cybaer/derTempomat/Hardware/dd.kicad_pcb

## KiCad design Hardware/dd.kicad_pcb (2018-09-26)

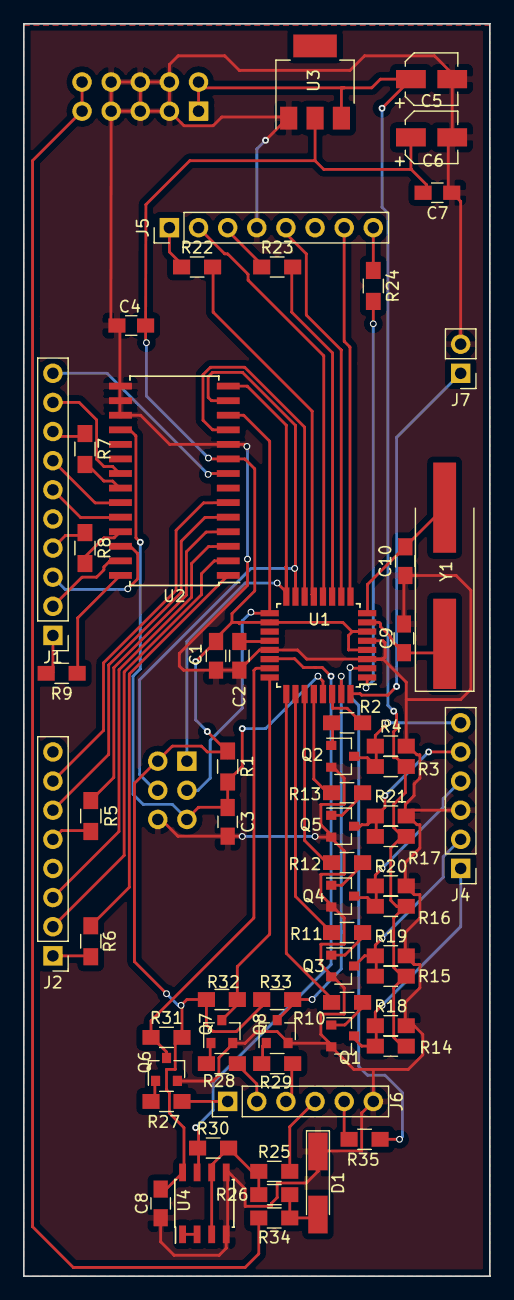
[picture p1: board dd.kicad_pcb from above]

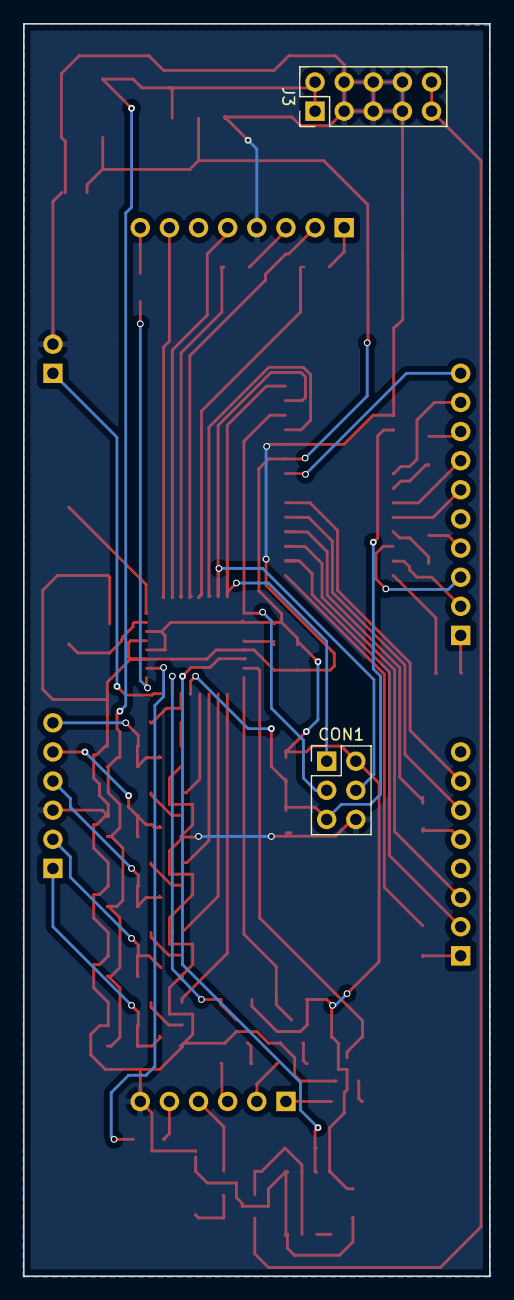
[picture p2: board dd.kicad_pcb from below]

Board: 2 copper layers, 40.6 x 109.2 mm, 67 parts (2 on the bottom side), 73 nets.

Parts:
C1, C2, C3, C4, C7, C8: 100n; C_0805_HandSoldering
C5, C6: 22µ; CP_Elec_4x5.3
C9, C10: 20p; C_0805_HandSoldering
CON1: AVR-ISP-6; Pin_Header_Straight_2x03_Pitch2.54mm
D1: 5V1; D_MiniMELF_Handsoldering
J1: Pin_Header_Straight_1x10_Pitch2.54mm
J2: Pin_Header_Straight_1x08_Pitch2.54mm
J3: Conn_02x05_Odd_Even; Pin_Header_Straight_2x05_Pitch2.54mm
J4, J6: Pin_Header_Straight_1x06_Pitch2.54mm
J5: Conn_01x08_Male; Pin_Header_Straight_1x08_Pitch2.54mm
J7: Conn_01x02_Male; Pin_Header_Straight_1x02_Pitch2.54mm
Q1, Q2, Q3, Q4, Q5, Q6, Q7, Q8: MMBT3904; SOT-23
R1, R2, R10, R11, R12, R13, R31, R32, R33: 10K; R_0805_HandSoldering
R3, R14, R15, R16, R17: 4K7; R_0805_HandSoldering
R4, R18, R19, R20, R21: 3K3; R_0805_HandSoldering
R5, R6, R7, R8, R9, R22, R23, R24, R35: 1K; R_0805_HandSoldering
R25, R26, R27, R28, R29, R30: 100K; R_0805_HandSoldering
R34: 5K; R_0805_HandSoldering
U1: ATMEGA328P-AU; TQFP-32_7x7mm_Pitch0.8mm
U2: MCP23S17; SOIC-28W_7.5x17.9mm_Pitch1.27mm
U3: LM1117-5.0; SOT-223
U4: MCP6002-xSN; SOIC-8_3.9x4.9mm_Pitch1.27mm
Y1: 20MHz; Crystal_SMD_HC49-SD_HandSoldering

Connections:
+12V: C5.1, J3.1, J3.2, R3.2, R14.2, R15.2, R16.2, R17.2, U3.3
-12VA: J3.9, J3.10, R34.2
-Ref: D1.2, R26.2, R34.1
/CV: R30.1, U1.22, U4.7
/Clk: Q6.3, R31.1, U1.23
/Debug: J7.1, U1.32
/LED1: R22.2, U1.13
/LED2: R23.2, U1.11
/LED3: R24.2, U1.1
/LED4: R35.2, U1.2
/Mod: Q8.3, R33.1, U1.31
/Rst: Q7.3, R32.1, U1.24
/T1: J5.2, U1.12
/T2: J5.5, U1.10
/T3: J5.7, U1.9
GND: C1.2, C2.2, C3.2, C4.2, C5.2, C6.2, C7.2, C8.2, C9.1, C10.1, CON1.6, D1.1, J3.3, J3.4, J3.5, J3.6, J3.7, J3.8, J4.3, J5.4, J6.6, J7.2, Q1.2, Q2.2, Q3.2, Q4.2, Q5.2, Q6.2, Q7.2, Q8.2, R4.2, R18.2, R19.2, R20.2, R21.2, U1.3, U1.5, U1.21, U2.10, U2.15, U2.16, U2.17, U3.1, U4.4, U4.5
unnamed: C2.1, U1.20
unnamed: C3.1, CON1.5, R1.2, U1.29, U2.18
unnamed: C9.2, U1.7, Y1.1
unnamed: C10.2, U1.8, Y1.2
unnamed: CON1.1, U1.16, U2.14
unnamed: CON1.3, U1.17, U2.12
unnamed: CON1.4, U1.15, U2.13
unnamed: J1.1, R9.1
unnamed: J1.2, U2.27
unnamed: J1.3, U2.26
unnamed: J1.4, R8.1
unnamed: J1.6, U2.24
unnamed: J1.7, U2.23
unnamed: J1.8, R7.1
unnamed: J1.9, U2.21
unnamed: J1.10, U2.8
unnamed: J2.1, R6.1
unnamed: J2.2, U2.2
unnamed: J2.3, U2.3
unnamed: J2.5, R5.1
unnamed: J2.6, U2.5
unnamed: J2.7, U2.6
unnamed: J4.1, Q1.3, R14.1, R18.1
unnamed: J4.2, Q3.3, R15.1, R19.1
unnamed: J4.4, Q4.3, R16.1, R20.1
unnamed: J4.5, Q5.3, R17.1, R21.1
unnamed: J4.6, Q2.3, R3.1, R4.1
unnamed: J5.1, R22.1
unnamed: J5.3, R23.1
unnamed: J5.8, R24.1
unnamed: J6.1, R27.2
unnamed: J6.2, R28.2
unnamed: J6.3, R29.2
unnamed: J6.4, R25.2
unnamed: J6.5, R35.1
unnamed: Q1.1, R10.1
unnamed: Q2.1, R2.1
unnamed: Q3.1, R11.1
unnamed: Q4.1, R12.1
unnamed: Q5.1, R13.1
unnamed: Q6.1, R27.1
unnamed: Q7.1, R28.1
unnamed: Q8.1, R29.1
unnamed: R2.2, U1.30
unnamed: R5.2, U2.4
unnamed: R6.2, U2.1
unnamed: R7.2, U2.22
unnamed: R8.2, U2.25
unnamed: R9.2, U2.28
unnamed: R10.2, U1.25
unnamed: R11.2, U1.26
unnamed: R12.2, U1.27
unnamed: R13.2, U1.28
unnamed: R25.1, R26.1, R30.2, U4.3, U4.6
unnamed: U1.14, U2.11
unnamed: U4.1, U4.2
VCC: C1.1, C4.1, C6.1, C7.1, C8.1, CON1.2, R1.1, R31.2, R32.2, R33.2, U1.4, U1.6, U1.18, U2.9, U3.2, U4.8
