cybaer/derTempomat/HardwareConfig.h

/*
 * HardwareConfig.h
 *
 *  Created on: 19.07.2018
 *      Author: cybaer
 *
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
 */

#ifndef HARDWARECONFIG_H_
#define HARDWARECONFIG_H_

#include "lib/ui/EdgeTrigger.h"
#include "avrlib/devices/switch.h"
#include "avrlib/devices/mcp23s17.h"
#include "avrlib/devices/bicolor_led_group.h"
#include "avrlib/devices/switch_group.h"


#include "avrlib/base.h"
#include "avrlib/gpio.h"
#include "avrlib/spi.h"
#include "avrlib/adc.h"

// __Compiler Bug__
__extension__ typedef int __guard __attribute__((mode (__DI__)));

extern "C" int __cxa_guard_acquire(__guard *);
extern "C" void __cxa_guard_release (__guard *);
extern "C" void __cxa_guard_abort (__guard *);
extern "C" void __cxa_pure_virtual();


using namespace avrlib;
static const uint8_t MAX_CV = 122;

typedef DebouncedSwitch< Gpio<PortB, 0> > Button_A;  // 12
typedef DebouncedSwitch< Gpio<PortD, 6> > Button_B;  // 10
typedef DebouncedSwitch< Gpio<PortD, 5> > Button_Mod;  // 9

typedef Gpio<PortB, 1> LED_A;  // 13
typedef Gpio<PortD, 7> LED_B;  // 11
typedef Gpio<PortD, 3> LED_Mod;  // 1
typedef Gpio<PortD, 4> LED_Takt;  // 2

typedef EdgeTrigger<Gpio<PortC, 0>, 0> ClockIn;  // 23
typedef EdgeTrigger<Gpio<PortC, 1>, 0> ResetIn;  // 24
typedef Gpio<PortD, 1> ModIn;  // 31

typedef Inverter<Gpio<PortC, 2> > Output_5;  // 6
typedef Inverter<Gpio<PortC, 3> > Output_4;  // 4
typedef Inverter<Gpio<PortC, 5> > Output_3;  // 2
typedef Inverter<Gpio<PortC, 4> > Output_2;  // 3
typedef Inverter<Gpio<PortD, 0> > Output_1;  // 1

// HW SPI
static const uint8_t SPI_Speed = 4;
typedef SpiMasterBase<MSB_FIRST, SPI_Speed> spi_master;

// Port Extender
typedef Gpio<PortB, 2> ExtenderSlaveSelect;
typedef MCP23S17<spi_master, ExtenderSlaveSelect, 0> portExtender;

typedef LED<PortPin<portExtender, PORT_A, 0>, PortPin<portExtender, PORT_A, 1> > LED_1;
typedef LED<PortPin<portExtender, PORT_A, 3>, PortPin<portExtender, PORT_A, 4> > LED_2;
typedef LED<PortPin<portExtender, PORT_A, 5>, PortPin<portExtender, PORT_A, 7> > LED_3;
typedef LED<PortPin<portExtender, PORT_B, 5>, PortPin<portExtender, PORT_B, 3> > LED_4;
typedef LED<PortPin<portExtender, PORT_B, 2>, PortPin<portExtender, PORT_B, 0> > LED_5;

typedef Switch<portExtender, PORT_B, 7> Switch_1;
typedef Switch<portExtender, PORT_A, 2> Switch_2;
typedef Switch<portExtender, PORT_A, 6> Switch_3;
typedef Switch<portExtender, PORT_B, 4> Switch_4;
typedef Switch<portExtender, PORT_B, 1> Switch_5;

typedef LEDGroup5 <LED_1, LED_2, LED_3, LED_4, LED_5> Leds;
typedef SwitchGroup5 <Switch_1, Switch_2, Switch_3, Switch_4, Switch_5> SWITCHES;


typedef Gpio<PortB, 7> Debug;                    // 10

static const uint8_t AdcChannelCV = 7;

extern Adc adc;

inline void initInputs(void)
{
  ResetIn::init();
  ClockIn::init();
  Button_A::Init();
  Button_B::Init();
  Button_Mod::Init();
}
inline void initOutputs(void)
{
  Output_1::set_mode(DIGITAL_OUTPUT);
  Output_1::set_value(true);
  Output_2::set_mode(DIGITAL_OUTPUT);
  Output_2::set_value(false);
  Output_3::set_mode(DIGITAL_OUTPUT);
  Output_3::set_value(false);
  Output_4::set_mode(DIGITAL_OUTPUT);
  Output_4::set_value(false);
  Output_5::set_mode(DIGITAL_OUTPUT);
  Output_5::set_value(false);
  Debug::set_mode(DIGITAL_OUTPUT);
  Debug::set_value(true);
  LED_A::set_mode(DIGITAL_OUTPUT);
  LED_A::set_value(false);
  LED_B::set_mode(DIGITAL_OUTPUT);
  LED_B::set_value(false);
  LED_Mod::set_mode(DIGITAL_OUTPUT);
  LED_Mod::set_value(false);
  LED_Takt::set_mode(DIGITAL_OUTPUT);
  LED_Takt::set_value(false);
}

inline void initAnalogIn(void)
{
  adc.Init();
}

inline void initHW(void)
{
  initInputs();
  initOutputs();
  initAnalogIn();
  spi_master::Init();
  portExtender::Init();
}

#endif /* HARDWARECONFIG_H_ */
