cybaer/derTempomat/(commit log)

2018-07-16 Scheme and PCB added
    [dd.kicad_pcb, dd.sch]
2018-07-22 LED4 added
    [dd.kicad_pcb, dd.sch]
2018-07-25 change Mod from pin19 to 31, add debug
    [dd.kicad_pcb, dd.sch]
2018-08-14 part references corrected
    [dd.kicad_pcb]
2018-09-26 footprint changed
    [dd.kicad_pcb, dd.sch]
